sahmad1729/ReactionWheelInvertedPendulum/code/agent_deployment/agent_deployment_code/Core/Inc/main.h

/*
 * main.h
 *
 *  Created on: Jan 19, 2021
 */

#ifndef INC_MAIN_H_
#define INC_MAIN_H_

#include "stm32f103xb.h"
#include "core_cm3.h"
#include <stdbool.h>
#include <stdio.h>
#include <math.h>

extern uint8_t TX_DATA[7];
extern int16_t wSpeed;

#endif /* INC_MAIN_H_ */
