sahmad1729/ReactionWheelInvertedPendulum/code/data_acquisition/data_acquisition_mcu/MF4005v2/Inc/input_signal.h

#ifndef INPUT_SIGNAL_H
#define INPUT_SIGNAL_H

#define SIGNAL_LENGTH 1000

const int8_t mlpr_signal[SIGNAL_LENGTH] = {
    -2, -2, -2, -2, -2, -2, -2, -2, -2, -2, -2, -2, -2, -2, -2, -2, -2, -2, -2, -2, -2, -2, -2, -2, -2, 2, 2, 2, 2, 2, 2, 2, 2, 2, 2, 2, 2, 2, 2, 2, 2, 2, 2, 2, 2, 2, 2, 2, 2, 2, -2, -2, -2, -2, -2, -2, -2, -2, -2, -2, -2, -2, -2, -2, -2, -2, -2, -2, -2, -2, -2, -2, -2, -2, -2, 2, 2, 2, 2, 2, 2, 2, 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
};
#endif // INPUT_SIGNAL_H
